rasitgokmen/EE463-Hardware-Project/Video link.md

Raşit Gökmen
EE463 Hardware Project
AC to DC Motor Drive

Youtube Link : https://youtu.be/tHf7YZv6PTA
