rasitgokmen/EE463-Hardware-Project/Report_rasitgokmen.docx

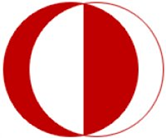
[picture p1: figure]

MIDDLE EAST TECHNICAL UNIVERSITY

DEPARTMENT OF ELECTRICAL AND ELECTRONICS ENGINEERING

EE463 - Static Power Conversion-I

Hardware Project Report

AC to DC Motor Drive

28/01/2018

Raşit GÖKMEN - 2333086

# 1. INTRODUCTION

The three basic switching power supply topologies in common use are the buck,boost, and buck-boost. These topologies are nonisolated, that is, the input and output voltages share a common ground. There are, however, isolated derivations of these nonisolated topologies. In this project, buck topology is used to step down the input voltage. To convert AC input voltage to input voltage of buck converter full bridge rectifier is used. A power mosfet is used as an switch and also a gate driver is used to drive this power mosfet and isolation. This report includes also computer simulations, component selections and power loss calculations.

# 2. TOPOLOGY SELECTION

AC/DC motor drive can be impelemented with various topologies. The AC input must be rectified. Diodes and thyristors are main component used in rectifier circuit. The gate control of thyristor is quite complicated and it can not controlled fixed value. They are also more expensive than diodes. So, rectification is implemented using diodes. As for number of phase of input voltage, single phase is consideration more convinient. Because, when three phase input voltage used, the voltage at the rectifier circuit is about 540V, so all components in the converter must be withstand this voltage. For this voltage level, it is hard to find commercial capacitor and mosfet etc. It is also expensive. Since the rated voltage of motor is 200V, approximately %70-80 duty cycle is enough with single phase input voltage. The inductor and capacitor at the output of buck converter act as a filter so output becomes more smoother. Also, filter capacitors are used at the rectifier output. The block diagram of selected topology is given below.

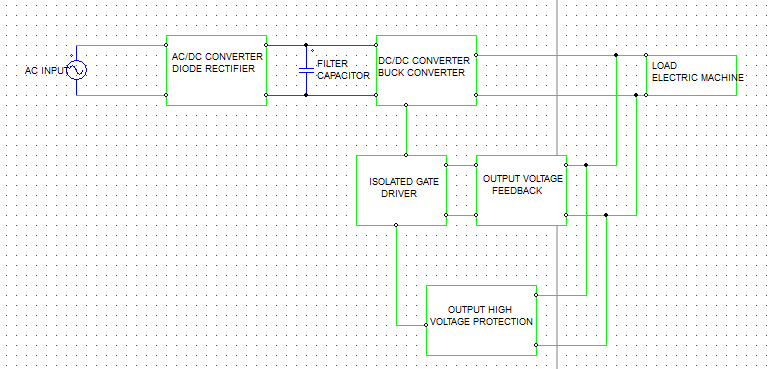
[picture p2: figure]

Figure 1 Block Diagram of selected topology

# 3. PROJECT SPECIFICATIONS

The project specifications are given in table 1 below.

Table 1 : Project Specifications

Input Voltage | 230Vrms
Line frequency | 50 Hz
Output Voltage | 120 - 200 V
Output Current | 6A
Duty Cycle | 0.625
Switching Frequency | 20 kHZ
Inductor current ripple | 50%

# 4. BRIDGE RECTIFIER

The input voltage of buck converter is produced from phase voltage using bridge rectifier. The body diodes of TO-247 mosfet’s are used as a diode. Output capacitance is calculated using simulation. 20 picies of 47uF capactior is used. The input voltage of buck converter is changing between 322V. Simulation result is shown in Figure 3.

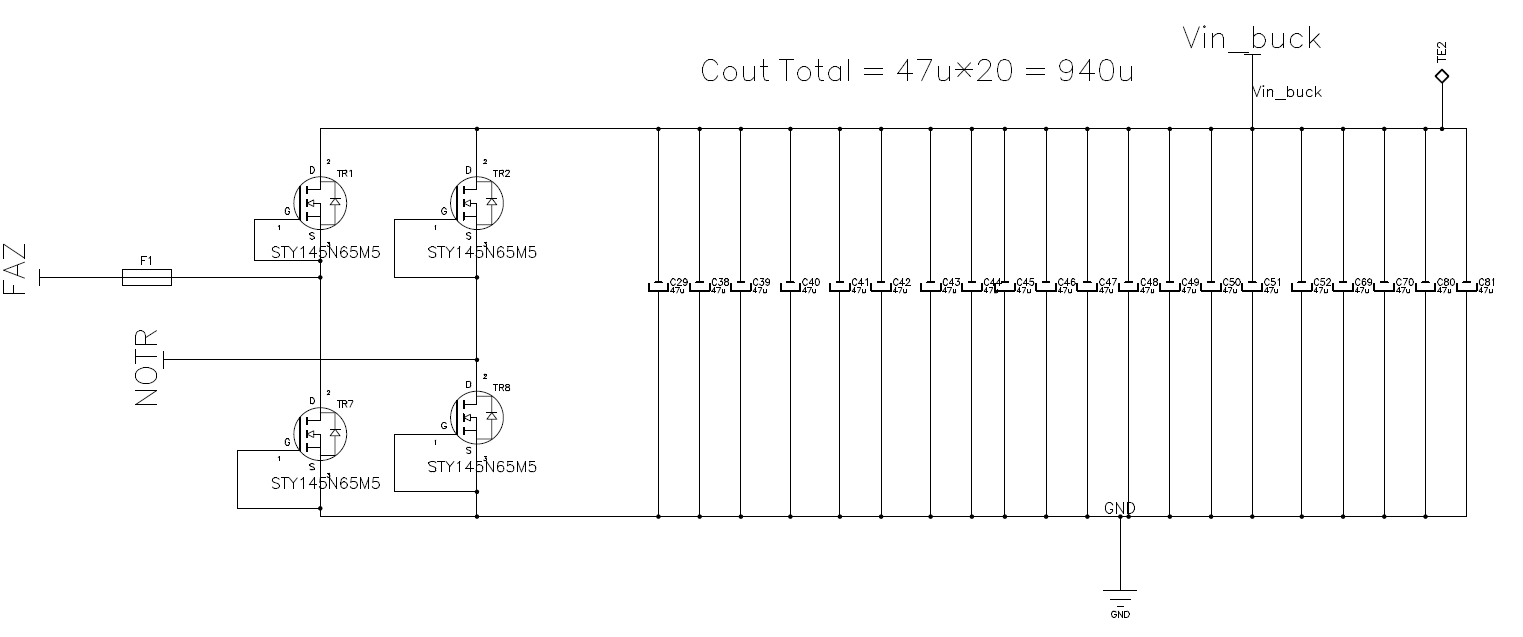
[picture p3: figure]

Figure 4.1 : Single Phase Bridge Rectifier

# 5. BUCK CONVERTER

A buck converter is implemented after the bridge rectifier output. The buck converter has the filter inductor on the output side, which provides a smooth continuous output current waveform to the load. Basic diagram of buck converter is given below.

Figure 5.1 (Buck Converter – Basic Diagram)

## 5.1 Component Selection :

The filter inductor value and its peak current are determined based on the specified maximum inductor current ripple.

Figure 5.2 Buck converter inductance calculation

From our specification table 1 . The inductor value is calculated :

L = (Vout)/(fsw) . ((1-D))/(∆IL) = 200/(20*10^3) . ((1-200/320))/(6*%50) = 1.25 mH (Equation 5.1)

As shown below 25 pieces of 47uH inductor is used. The total inductance is 1.175 mH. The maximum rms current and saturation current of this inductor is 8.5A. For 6A output current, the maximum value of inductor current is 7.64 A which is in safety range. The curent waveform of inductor for worst case i.e for maximum input voltage and maximum output current is given below.

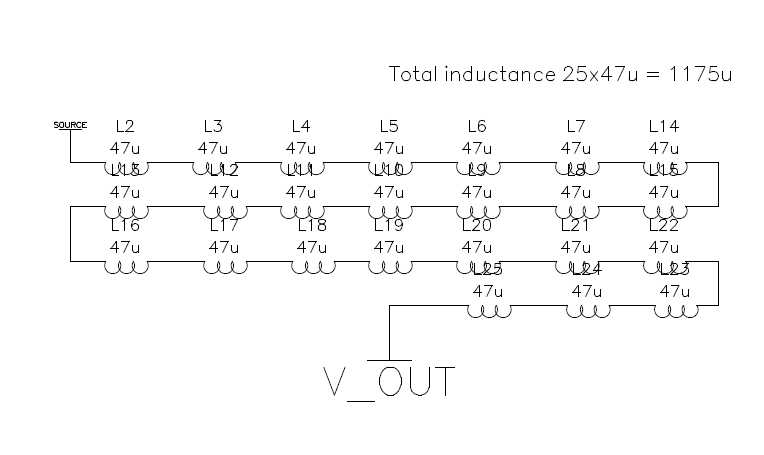
[picture p4: figure]

Figure 5.3 A series connection of inductors to obtain inductance value

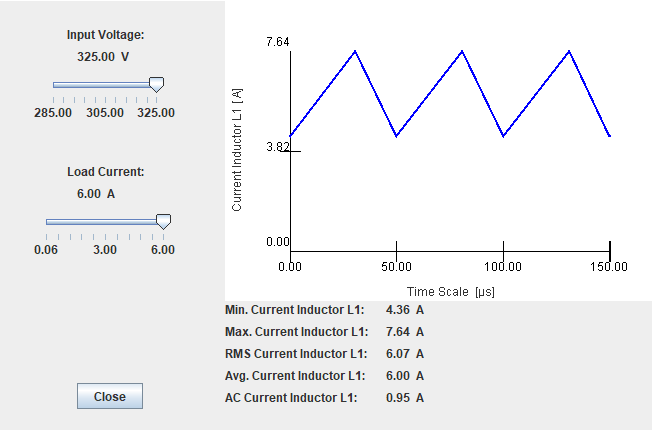
[picture p5: figure]

Figure 5.4 Inductor current waveform for selected inductance

For continuous inductor current mode operation, to determine the amount ofcapacitance needed asa function of inductor current ripple, ∆IL , switchingfrequency, fs, and desired output voltageripple, ∆ Vo, the following equation is used assuming all the output voltage ripple is due to the capacitor’scapacitance.

(Equation 5.2)

where ∆IL=7.64-4.36=3.28 A

fs = 20 kHz

∆ Vo = %10 (assumed)

So C is must be greater than 205 uF. The output capacitance is choosed 20*47uF = 940uF. 20 pieces of capacitor used, because the maximum rms current rating of selected capacitor is 0.4 A . To not exceed this current rating, the output current is shared to 20 pieces of capacitor. The rms current of each capacitor ;

Iout(rms) / 20 = 6.07/20 = 0.3 A which is in safety region.

The switch is implemented by using power mosfet. This mosfet must withstand with the voltage which is observed 325 V in simulation but it may be greater in experimental enviroment due to transient overshoot. It must also be capable to carry minimum 7.64 A current. A power mosfet with x product number which is 650V, 138A TO247 package is selected. The datasheet of this mosfet given in appendix section at the end of this report.

The selection process of free wheeling diode is same with the selection process of switch. It will be also used with heatsink.

## 5.2 Power losses calculation :

### 5.2.1 Switch(main mosfet) Losses :

The different losses which can be seen in the FET of a power supply are conducted losses, switching losses, Coss losses, and body diode losses. Reverse recovery losses are neglected, but can become significant at high switching frequencies.

Pcond = IFET(rms)² * Rds(on) = 6.07 * 0.012 Ω = 0.44 W

Psw = VDS * (fsw)/2 * (trise * IFET,min + tfall* IFET,max )

Psw = 300V * (20*10^3)/2 *( 11ns* 0 + 82ns* 6 ) = 1.476 W

PCoss = Coss * VDS * (fsw)/2 = 413pF* 300V * 10kHz = 1.24 mW

Ptotal = 0.44 + 1.476 + 1.24*10⁻³ = 1.916 W

### 5.2.2 Diode Power Loss :

PDiode = Io * VF *(1-D)= 6.07*0.7*(1-0.625) = 1.6 W

## 5.3 Output Voltage Feedback Control Loop :

Since the switching frequency of switching regulators is at range ten to hundered kHz , there are overshoot at the output voltage and current. To reduce this overshoots i.e to set the output voltage or current at fixed value, voltage control or current control techniques are used. In this project, our specification is speed control of dc motor. Since the speed of dc motor is proportional with its armature voltage (buck output voltage) a voltage control loop is designed.

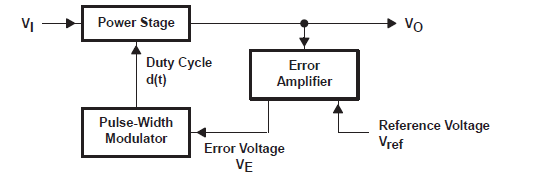
[picture p6: figure]

Figure 5.5 Control Loop Components

Control Stage :

As shown below, output voltage is sampled with a resistor divider and compared with the reference voltage of error amplifier positive input. Then, the output of error amplifier is compared with a sawtooth waveform with period frequency of switching frequency. The comparator is then produce a pwm signal. This pwm signal is the input of isolated gate driver.

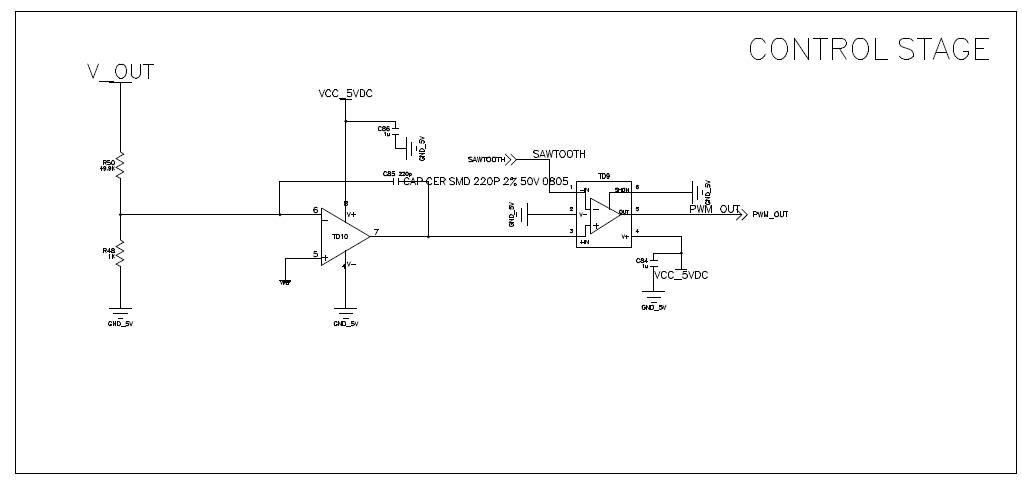
[picture p7: figure]

Figure 5.6 Control stage schematic

As shown below, whenever error amplifier output is greater than sawtooth wavefrom, the gate signal goes high. Similarly, whenever error amplifier output is greater than sawtooth wavefrom, the gate signal goes low. The error amplifier output changes it's states when input voltage greater or less than reference voltage (scaled set voltage). In summarize, this circuits is changes the duty cycle of gate signal of switch to keep output voltage constant. TLV3501 comparator with 4.5 ns propogation delay is used.

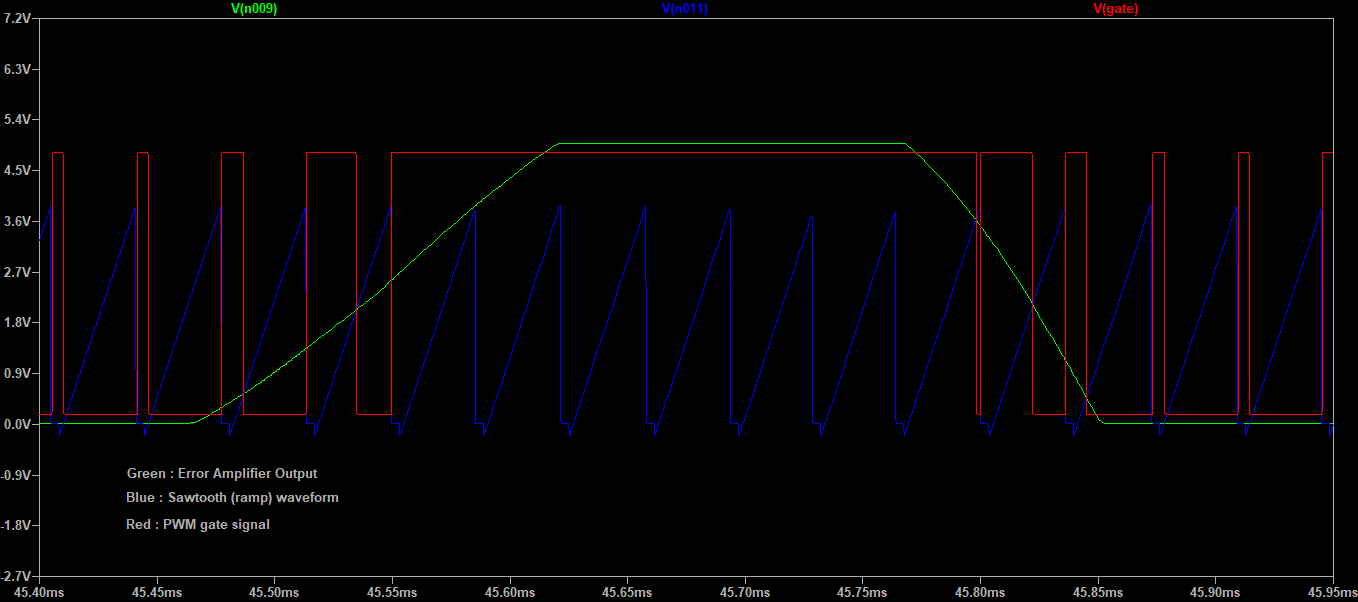
[picture p8: figure]

Figure 5.7 Control stage waveforms

Sawtooth wavefrom generation :

A sawtooth(ramp) waveform generator circuit is given below. The left side pnp transistor is acts as a current source and charges the C5 capacitor. Whenever the voltage across this capacitor is greater than the U3 positive input capacitor is discharge through npn transistor Q5. The charge period of this capacitor is much larger than the discharge period. The total period of this waveform is almost same with the period of the converter. The output(voltage across C5) of this circuit given below.

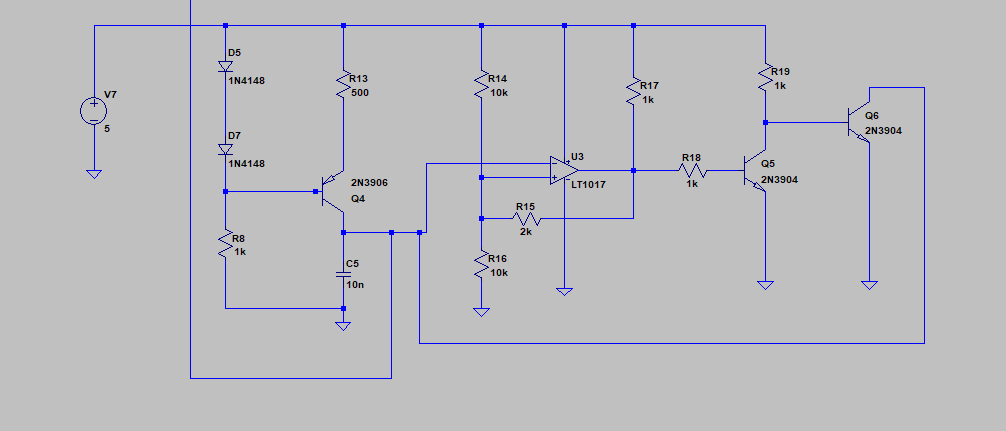
[picture p9: figure]

Figure 5.8 Sawtooth waveform generator schematic

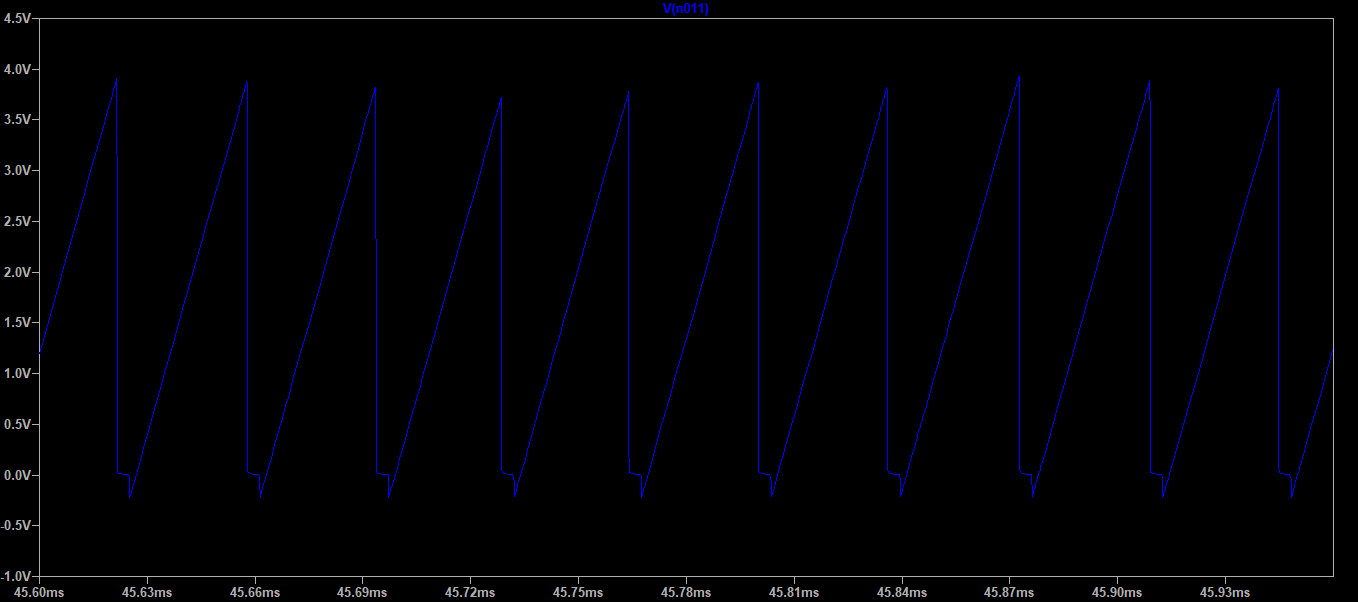
[picture p10: figure]

Figure 5.9 Sawtooth waveform with period of switch

5V DC voltage generation for IC's supply pins :

A 5V DC voltage is generated by using linear voltage regulator MIC29502BU is used as shown below.

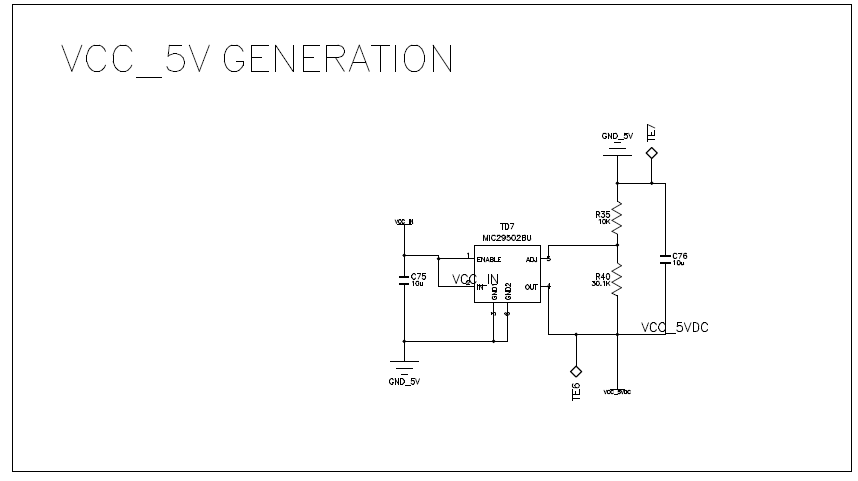
[picture p11: figure]

Figure 5.10 5V DC voltage generation

## 5.4 Gate Drive of Mosfet :

Isolated gate drivers are essential components for high side mosfet driver. ACNW3190 is used for gate driver. It has input, ouput and supply pins. Its minus supply pins connected to source of mosfet. And its positive supply pins are connected to the 15V + Vsource. To produce this source referenced isolated 15V, as shown below Figure 5.11, an isolated DC/DC converter is used. It is input is 5V and its output is 15V. They are isolated each other its output ground is connected to source of mosfet.

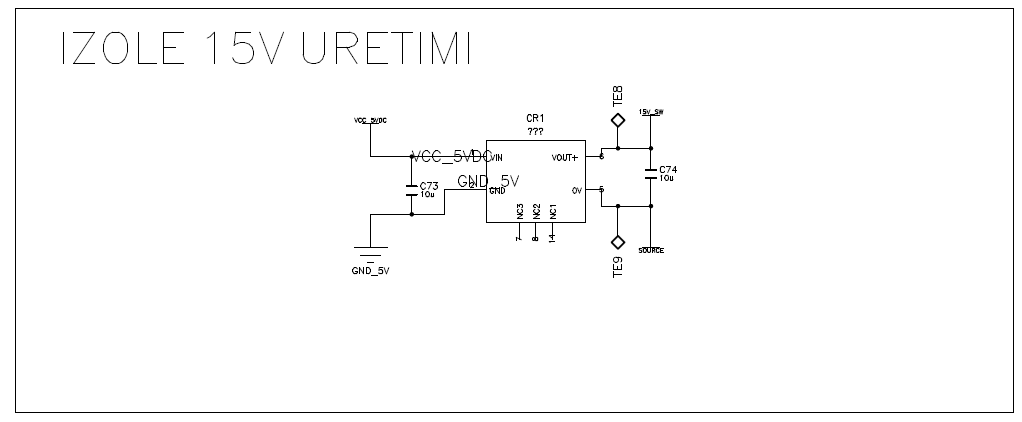
[picture p12: figure]

Figure 5.11 Isolated 15V generation for gate driver

The gate driver uses pwm signal as an input and gives 15V output referenced to source voltage i.e VGS . It has output resistance to limit the current on the gate of mosfet. The schematic of gate driver shown below Figure 5.12 . The "PWM_OUT" signal is the output of output voltage control circuit. "PWM_OFF" signal is the output of output high voltage comparator.

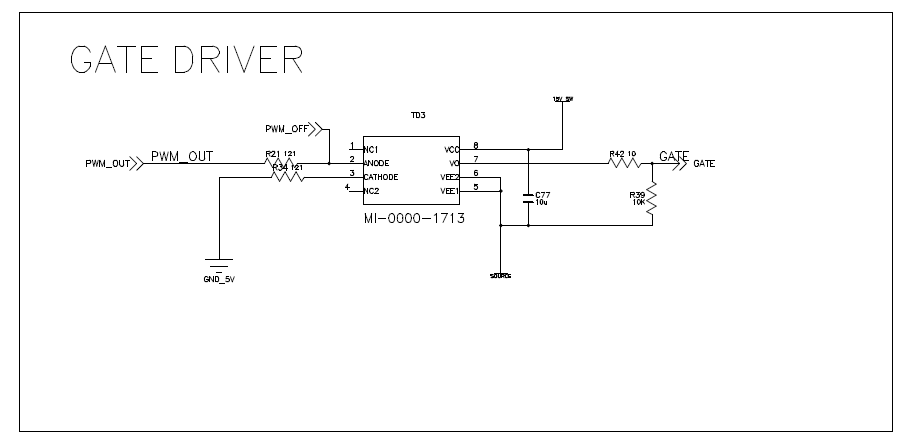
[picture p13: figure]

Figure 5.12 Gate driver schematic

# 6. SIMULATIONS

Computer simulation of the project is done using LTspice. Each part of project such as bridge rectifier, buck converter, output voltage controller, output high voltage protection are simulated seperately. The effect of output voltage controller to output voltage, output voltage set value's variations with changing potantiometer value, effect of the output high voltage comparator to output voltage are investigated.

## 6.1 Single phase full-bridge rectifier

The single phase full bridge rectifier circuit is shown below simulated in LTspice.

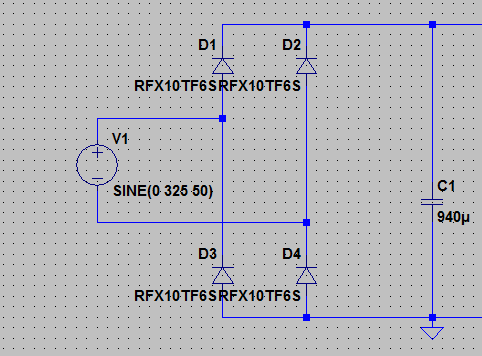
[picture p14: figure]

Figure 6.1 Circuit Schematic of Single-pase bridge rectifier

The output capacitors is charged to 325V initially and makes the output voltage constant DC as shown below.

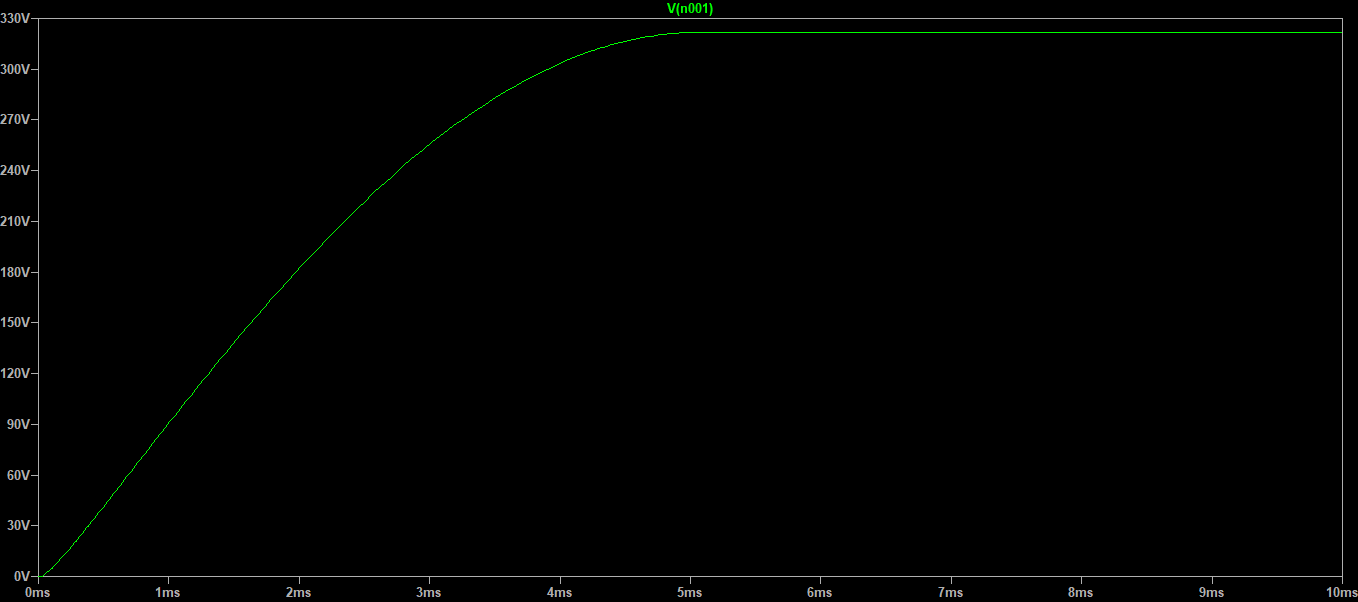
[picture p15: figure]

Figure 6.2 Output voltage waveform of bridge rectifier

## 6.2 Buck Converter

The overall circuit schematic is shown below Figure 6.2.1.

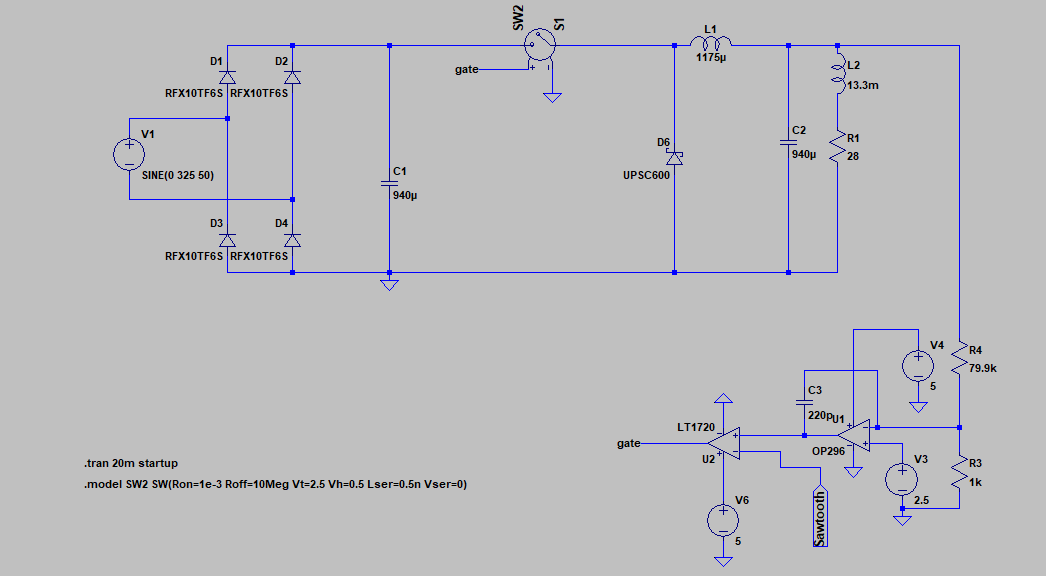
[picture p16: figure]

Figure 6.3 Overall circuit schematic of project

The output voltage of buck converter is shown below. Thanks to feedback loop, output voltage ripple is only 5V (%2.5) . The first overshoot is the due to start up. Initially, output capacitor is discharged and they are charged to 200V. Since the charged voltage is too high, they sinks large current and overshoot occurs.

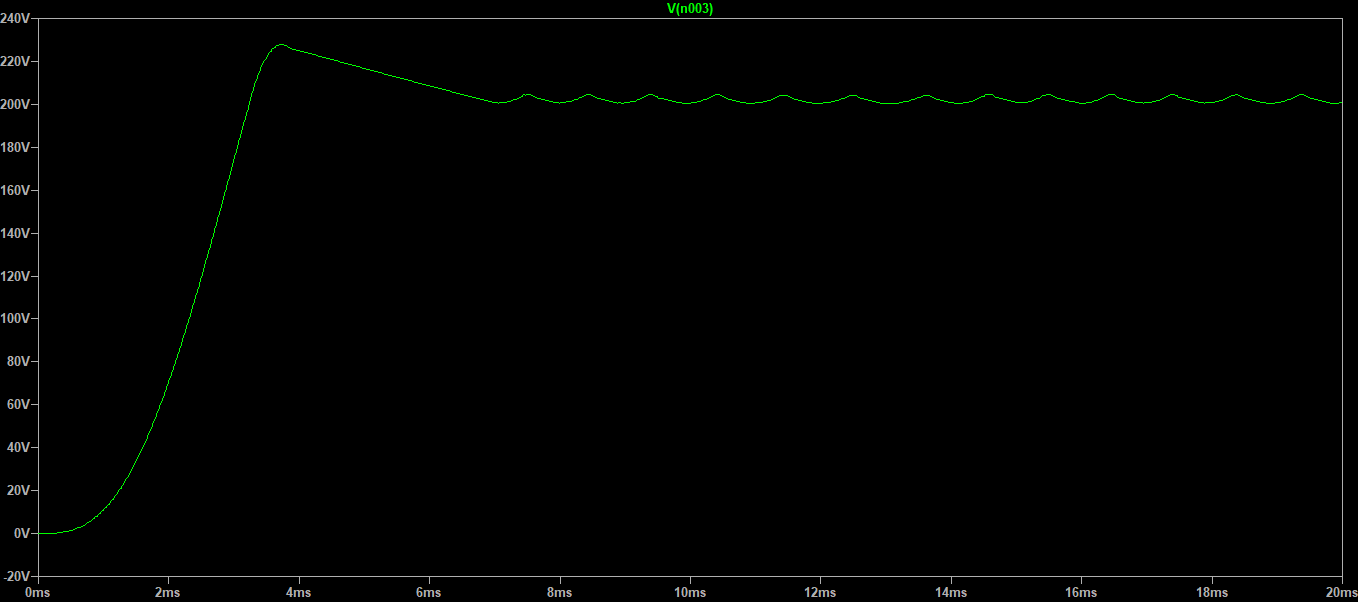
[picture p17: figure]

Figure 6.4 Output voltage waveform with feedback loop

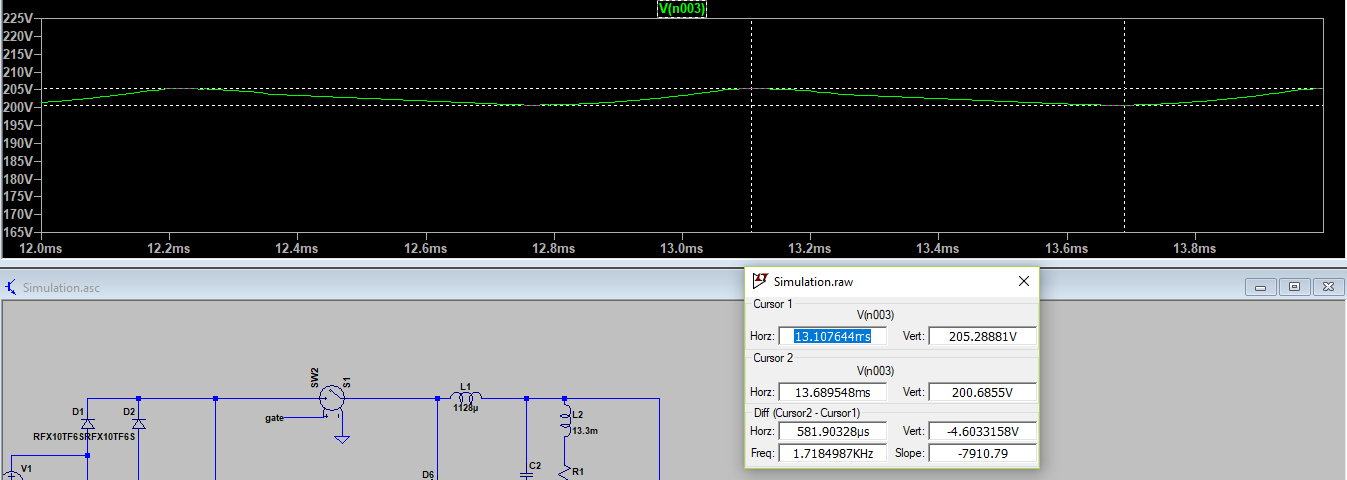
[picture p18: figure]

Figure 6.5 Output voltage ripple with feedback loop

### 6.2.1 Changing reference voltage V3

The reference voltage changes with potantiometer. As shown below, Vref is generated from below circuit. The voltage regulator TLVH413B is used to make the reference voltage constant.

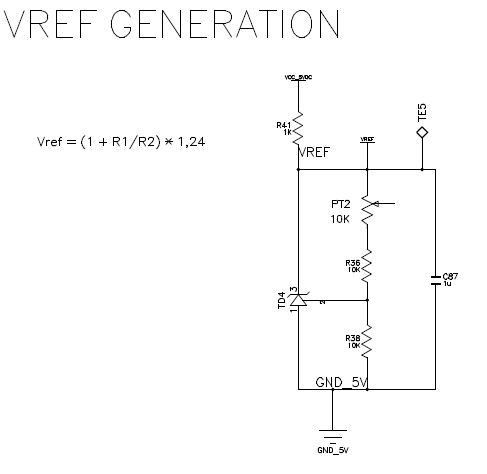
[picture p19: figure]

Figure 6.6 Reference voltage generation with potantiometer

Now, the set value of output voltage is reduced to 120V. Motor speed can be changed by this way.

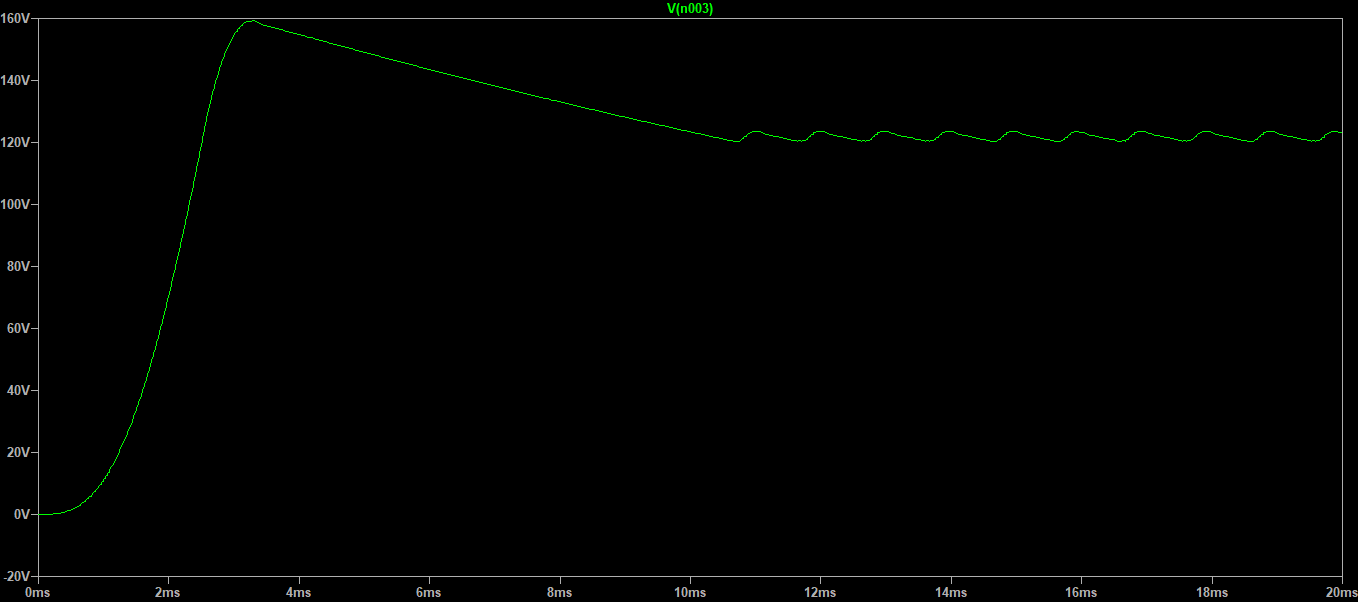
[picture p20: figure]

Figure 6.7 : Output voltage with different Vref

### 6.2.2 Output voltage control

The circuit shown below is a simple voltage control loop.

As seen from figure 6.9, output voltage is sampled with a resister divider and compared with a reference voltage then a waveform called error amplifier output is produced.

The output is error amplifier is compared with a sawtooth(ramp) waveform then a pwm signal is produced. Whenever, error amplifier output is greater than sawtooth waveform the output pwm signal is high(5V). Similarly, whenever error amplifier output is less than sawtooth waveform the output pwm signal is low(0V). This can be seen from figure 6.10 . This PWM signal is used as an input of gate driver to drive mosfet.

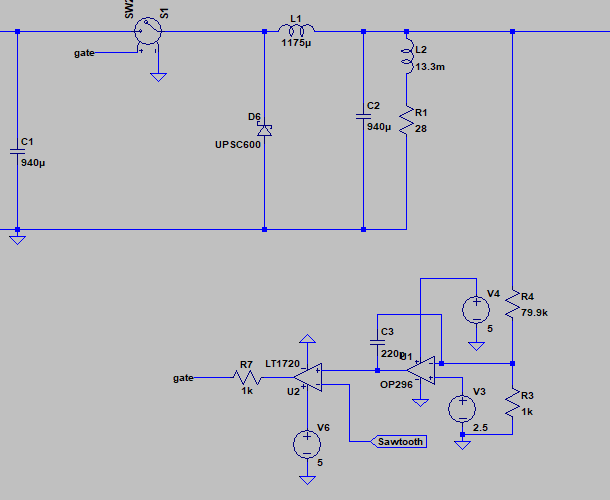
[picture p21: figure]

Figure 6.8 Ouput voltage control loop

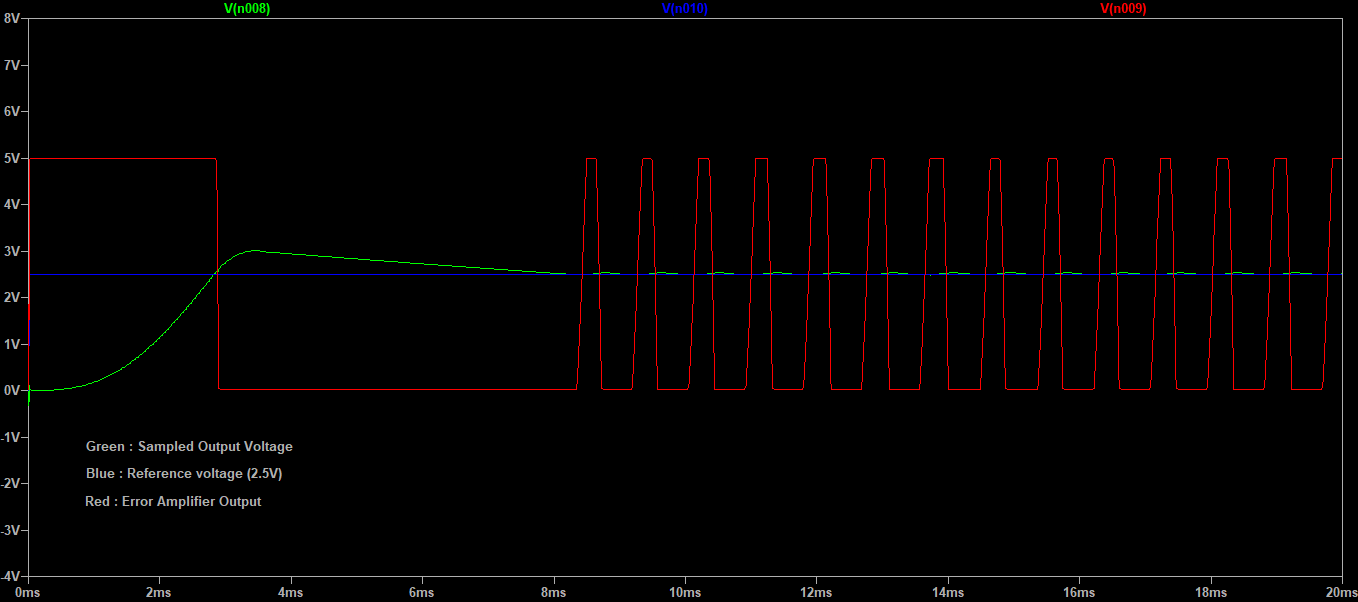
[picture p22: figure]

Figure 6.9 Opamp(U1) inputs and output waveforms

Figure 6.10 Comparator (U2) inputs and output waveforms

### 6.2.3 Output High Voltage Protection

To protect motor from high voltage, a high voltage comparator circuit is implemented. When output voltage exceeds the set voltage 225 V, comparator output (the pwm signal) goes zero i.e switch turns off.

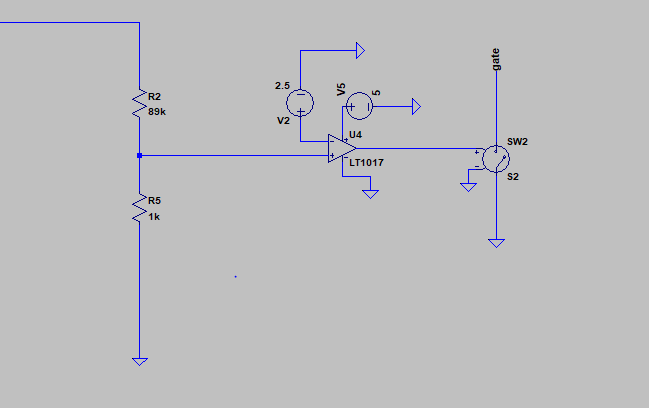
[picture p23: figure]

Figure 6.11 Output High Voltage Comparator

Without output high voltage protection the output voltage is shown below. As seen, it reaches to 240V. This voltage may be dangerous for motor.

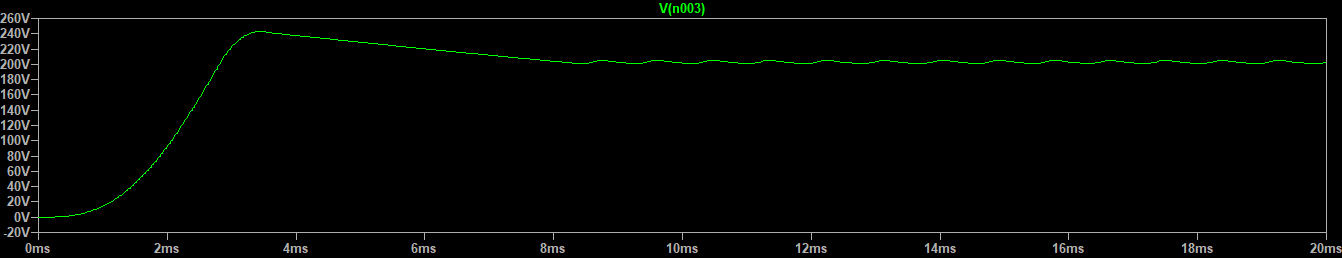
[picture p24: figure]

Figure 6.12 Output voltage waveform without high voltage comparator

By using output high voltage comparator, output voltage is limited below 230V as shown blow Figure 6.13 .

Figure 6.13 Output voltage waveform with high voltage comparator

When output voltage is higher than 225V, the PWM signal of gate driver is pulled down by this circuit. The output voltage and pwm signal of gate driver is given in same graph shown below Figure 6.14 .

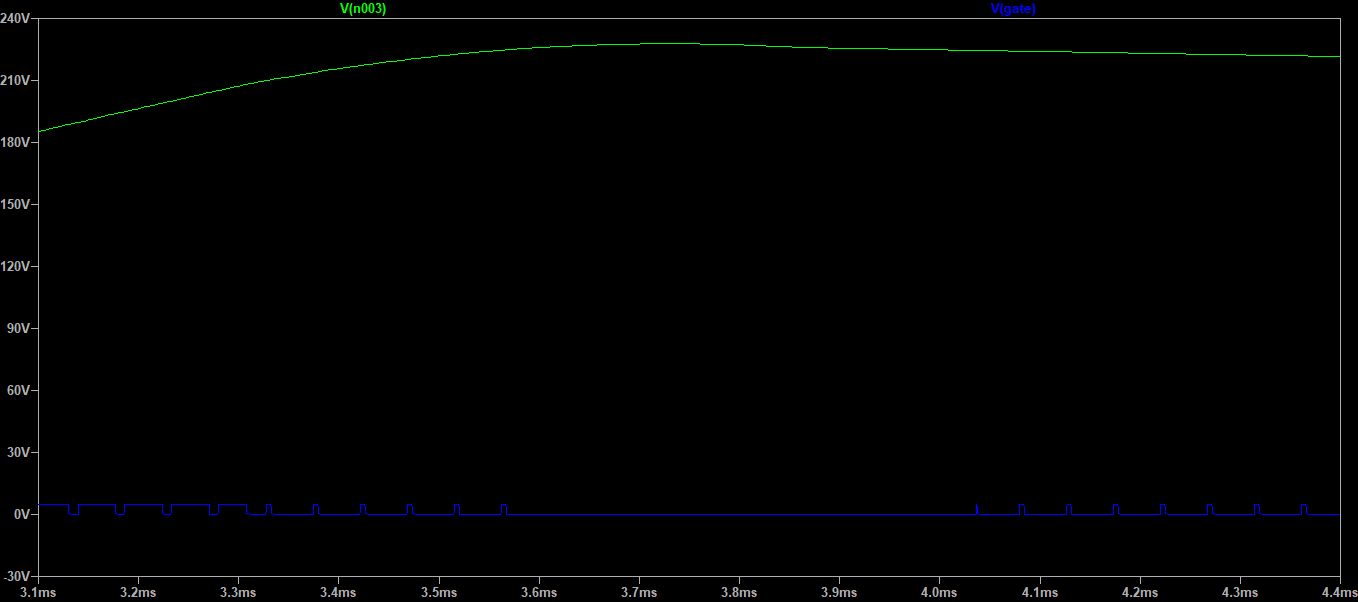
[picture p25: figure]

Figure 6.14 Output voltage waveform and pwm signal of gate driver

# 7. TEST RESULTS

Test results will be summitted as a seperate report after project demo presentation. Video of demo also will be submitted after demo presentation.

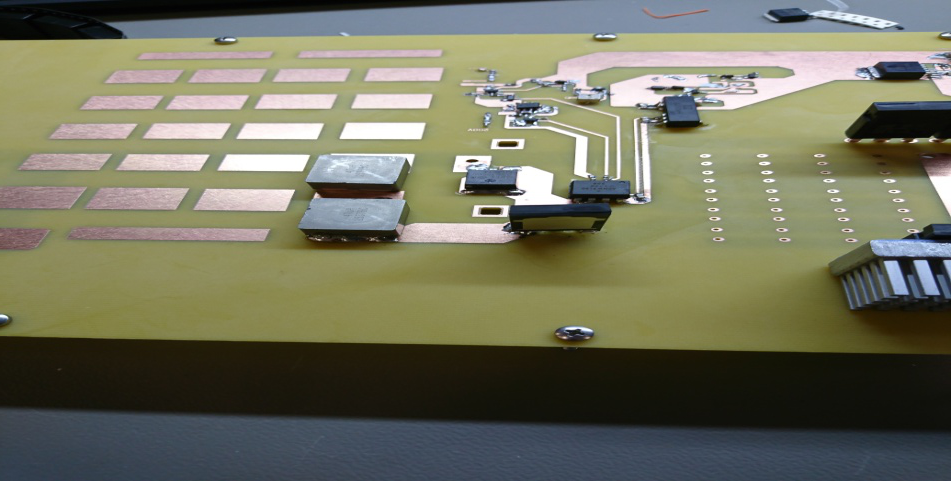
[picture p26: figure]

To be soon :)

# 8. CONCLUSION

In this project, a AC/DC converter is implemented. As an input, phase voltage of grid used. To convert AC to DC full bridge rectifier is impelemented. As an switching DC/DC converter, buck converter is implemented. Buck converter components such as inductor,capactior are calculated. Also, other components are selected appropriate with project specifications.

In buck converter, input supplies current to both the inductor and load when the switch is on. When the switch is off, inductor supplies the current to load. So, there will be ripple in the inductor current. This ripple should not exceeds inductor saturation current otherwise inductance may be degrade. The FWD diodes conducts when switch is off and carries inductor current. So, it must be selected appropriate for continuous current carrying capability.

Without voltage control loop, the output of buck converter may be unstable. Even, there will be overshoot when the switch turning on and off. The control loop consist of error amplifier and pulse width modulator. The error amplifier compares output voltage with reference voltage. Pulse width modulator compares error amplifier output with sawtooth waveform then produce pwm signal to the gate driver input.

Isolated gate drivers are essential components for high side mosfet driver. It has input, ouput and supply pins. Its minus supply pins connected to source of mosfet. And its positive supply pins are connected to the 15V + Vsource. To produce this 15V, source referenced isolated voltage an isolated DC/DC converter is used. It is input is 5V and its output is 15V. They are isolated each other its output ground is connected to source of mosfet.

A PCB is designed. In PCB design, there are some points which are important. One of them is that by pass capacitor should be connected as close as possible to the corresponding IC. The another one, plane or trace should be large to carry high current. And also, output voltage traces connected to output voltage controller circuit should be as far as possible to switching node since there will be noise in the switching node.

# 9. APPENDICES

1. Power Stage Designer User's Guide - Texas Instruments (http://www.ti.com/lit/pdf/slvubb4) from

www.ti.com/lit/pdf/slvubb4

2. Understanding Buck Power Stages In Switchmode Power Supplies (http://www.ti.com/general/docs/litabsmultiplefilelist.tsp?literatureNumber=slva057) from

www.ti.com/lit/an/slva057/slva057.pdf

3. ACNW3190 Gate Driver from www.farnell.com/datasheets/76300.pdf

4. TLV3501 ultrafast comparator from www.ti.com/lit/ds/sbos533b/sbos533b.pdf

5. ISJ0515A DC/DC converter from www.xppower.com/Portals/0/SF_ISJ.pdf

6. MIC29502BU Linear Voltage Regulator from ww1.microchip.com/downloads/en/.../20005685A.pdf

7. STY145N65M5 Power mosfet 650V-139A from www.st.com/resource/en/datasheet/sty145n65m5.pdf
