rasitgokmen/EE463-Hardware-Project/Block_diagram.png

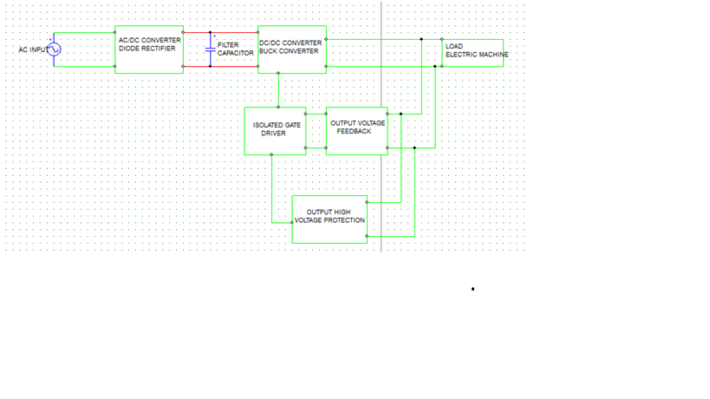
Block_diagram.png
