rasitgokmen/EE463-Hardware-Project/Simulation.asc

C1: cap; 940µ; Rser=0.1
C2: cap; 940µ; Rser=0.1
C3: cap; 220p
C5: cap; 10n
D1: diode; RFX10TF6S
D2: diode; RFX10TF6S
D3: diode; RFX10TF6S
D4: diode; RFX10TF6S
D5: diode; 1N4148
D6: schottky; UPSC600
D7: diode; 1N4148
L1: ind; 1128µ; Rser=0.1
L2: ind; 13.3m
Q4: pnp; 2N3906
Q5: npn; 2N3904
Q6: npn; 2N3904
R1: res; 28
R3: res; 1k
R4: res; 49.9k
R8: res; 1k
R13: res; 500
R14: res; 10k
R15: res; 2k
R16: res; 10k
R17: res; 1k
R18: res; 1k
R19: res; 1k
S1: sw; SW2
U1: OP296
U2: LT1720
U3: LT1017
V1: voltage; SINE(0 325 50)
V3: voltage; 2.5
V4: voltage; 5
V6: voltage; 5
V7: voltage; 5
Named nets: 0, gate
.tran 20m startup
.model SW2 SW(Ron=1e-3 Roff=10Meg Vt=2.5 Vh=0.5 Lser=0.5n Vser=0)
